fedurca/het68_3d_case/reference/img/prototyp.jpg

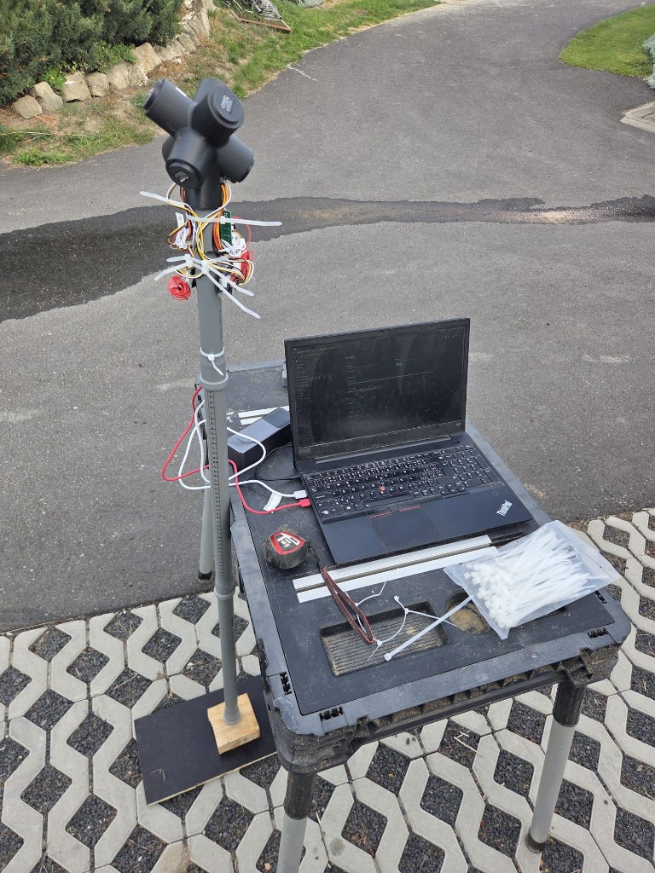
reference/img/prototyp.jpg
