fedurca/het68_3d_case/reference/img/spojka-iso.jpg

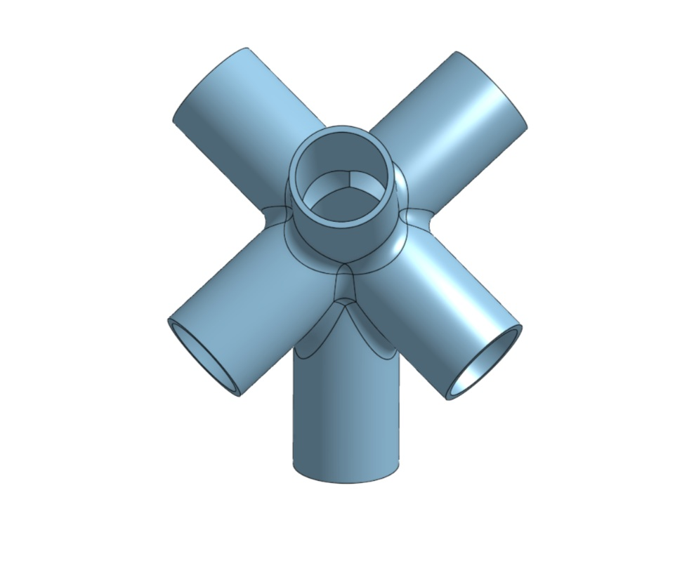
reference/img/spojka-iso.jpg
