fedurca/het68_3d_case/reference/img/spojka-rez.jpg

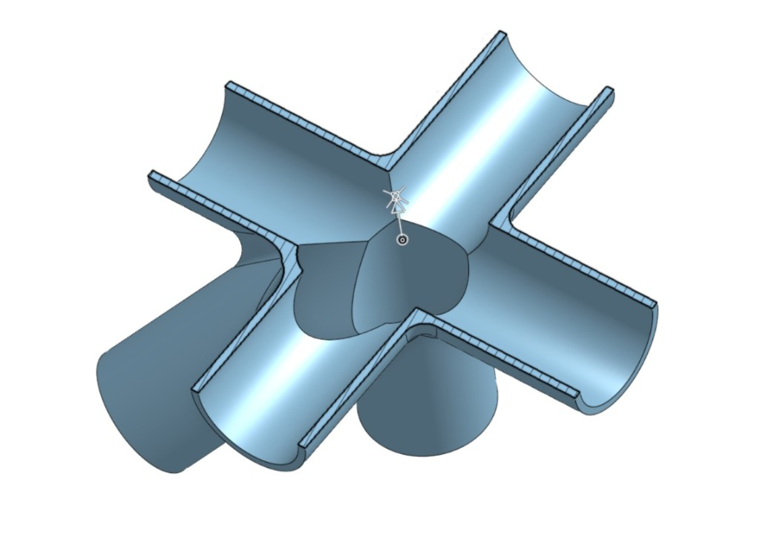
reference/img/spojka-rez.jpg
