fedurca/het68_3d_case/reference/img/spojka-vykres.jpg

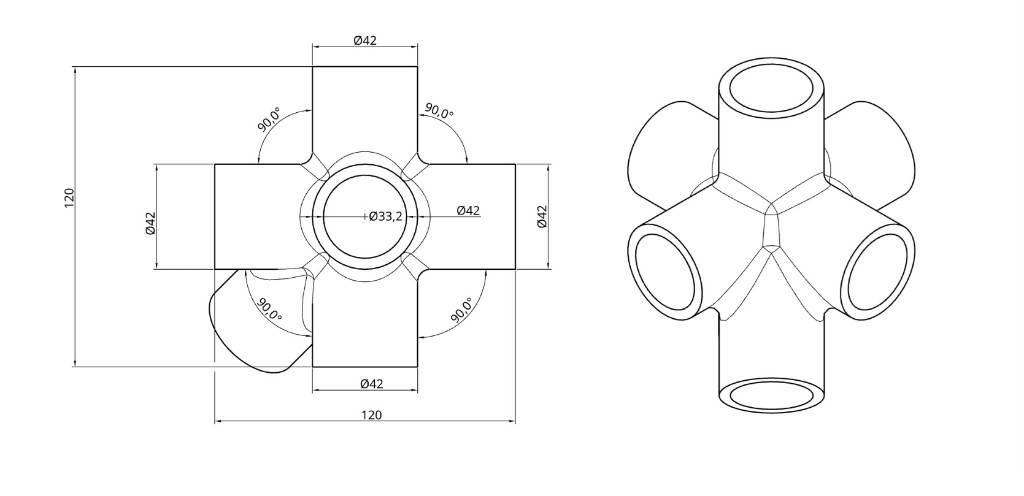
reference/img/spojka-vykres.jpg
