fedurca/het68_3d_case/reference/img/vicko-iso.jpg

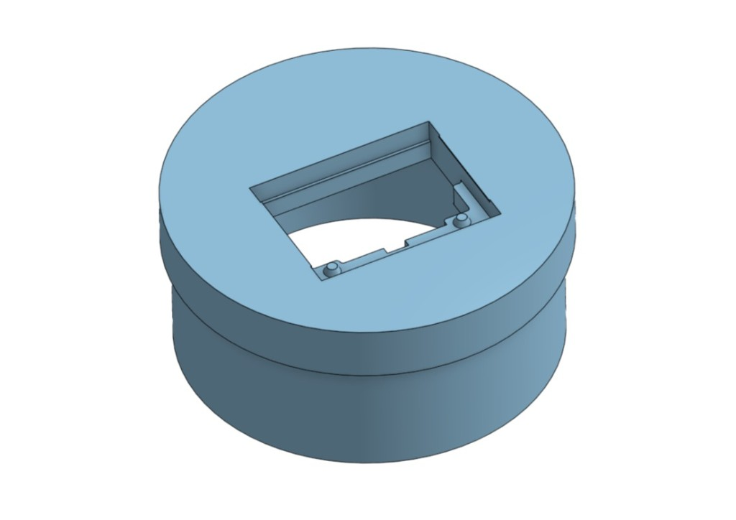
reference/img/vicko-iso.jpg
