fedurca/het68_3d_case/reference/img/vicko-pohled.jpg

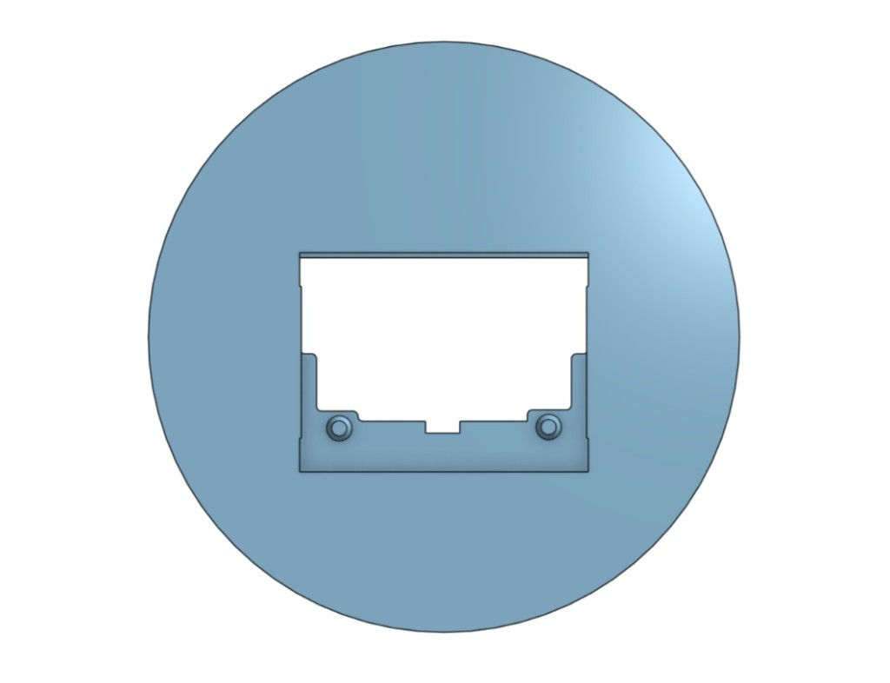
reference/img/vicko-pohled.jpg
