fedurca/het68_3d_case/export/step/pod.step

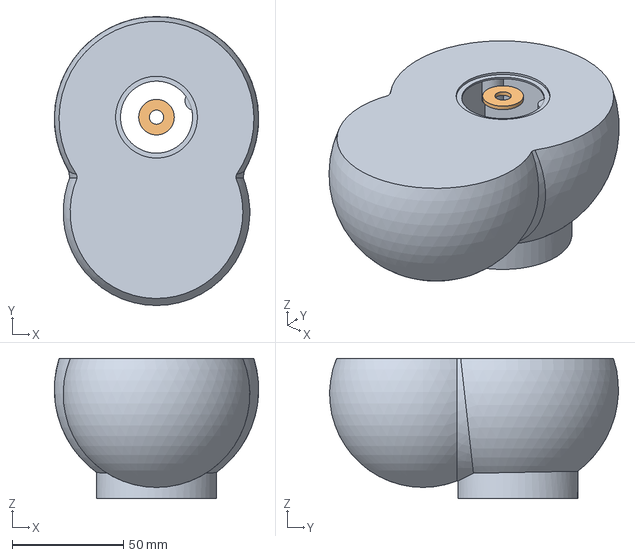
[picture p16: CAD file, 2026-10-29]
export/step/pod.step
91.9 x 130.0 x 63.0 mm
