fedurca/het68_3d_case/reference/stl/vicko.stl

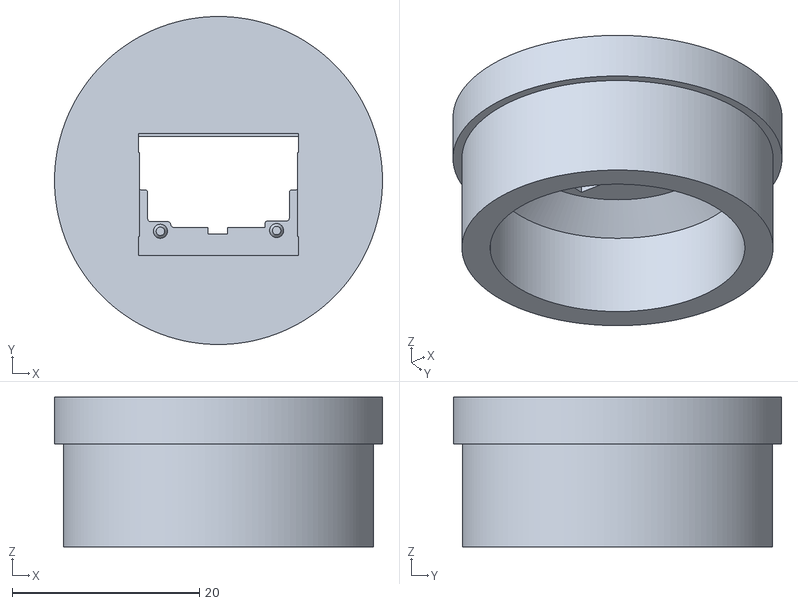
[picture p17: CAD file, 2026-10-29]
reference/stl/vicko.stl
35.0 x 35.0 x 16.0
