fedurca/het68_3d_case/export/step/hub_lower.step

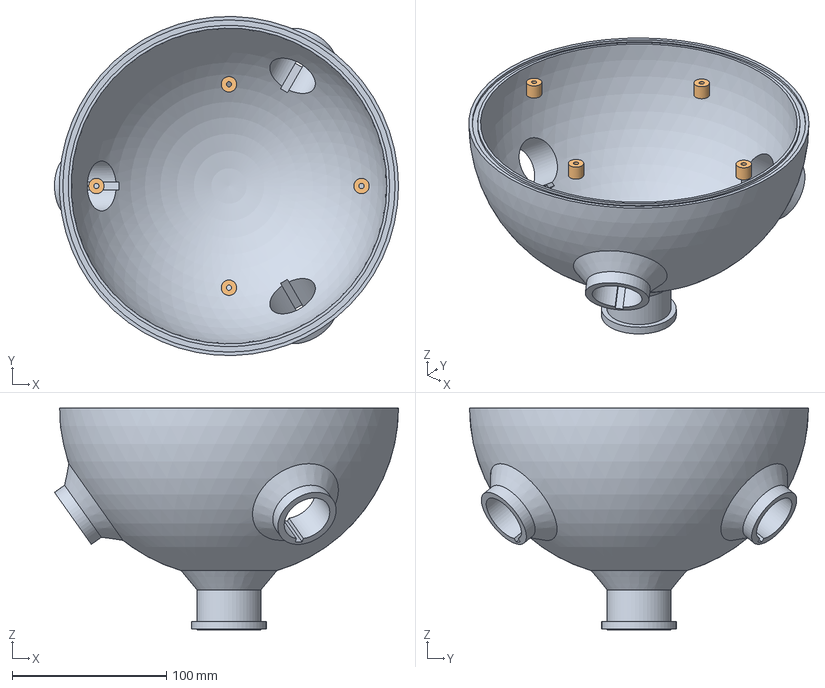
[picture p18: CAD file, 2026-10-29]
export/step/hub_lower.step
223.2 x 219.9 x 144.0 mm
