fedurca/het68_3d_case/reference/stl/spojka.stl

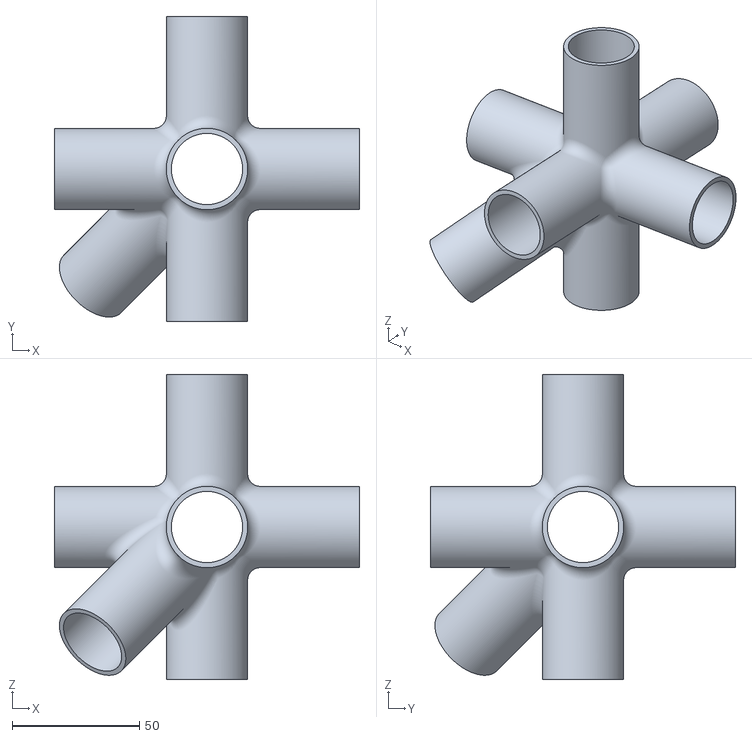
[picture p19: CAD file, 2026-10-29]
reference/stl/spojka.stl
120.0 x 120.0 x 120.0
