fedurca/het68_3d_case/export/step/pod_window.step

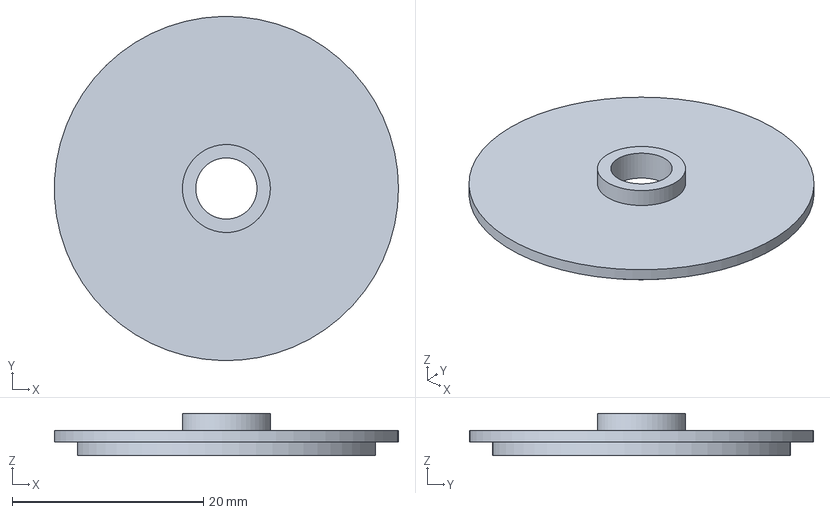
[picture p20: CAD file, 2026-10-29]
export/step/pod_window.step
36.0 x 36.0 x 4.40 mm
