fedurca/het68_3d_case/export/step/marks.step

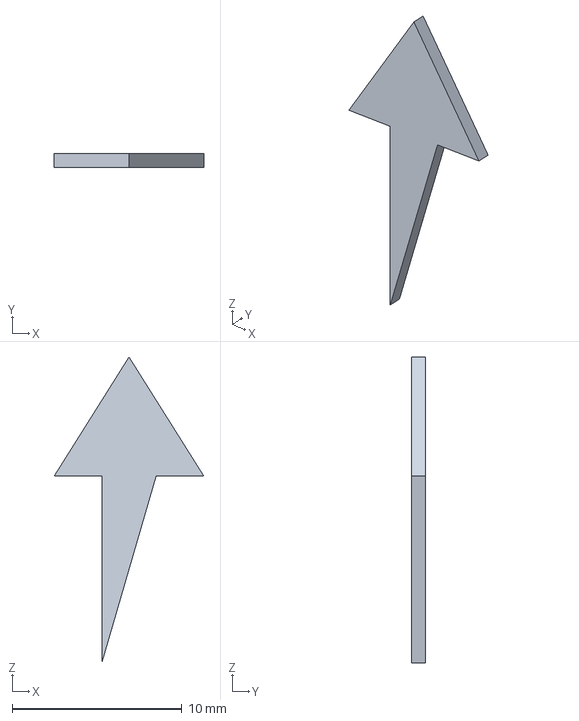
[picture p21: CAD file, 2026-10-29]
export/step/marks.step
8.80 x 0.8 x 18.0 mm
