fedurca/het68_3d_case/export/step/arm.step

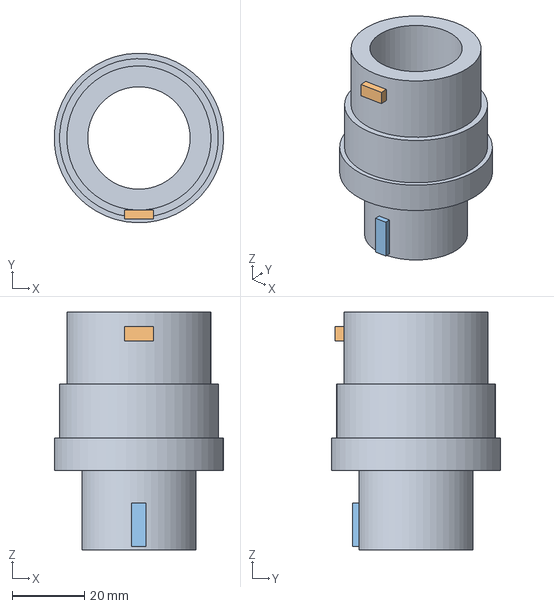
[picture p22: CAD file, 2026-10-29]
export/step/arm.step
47.0 x 47.0 x 66.0 mm
