fedurca/het68_3d_case/export/step/hub_upper.step

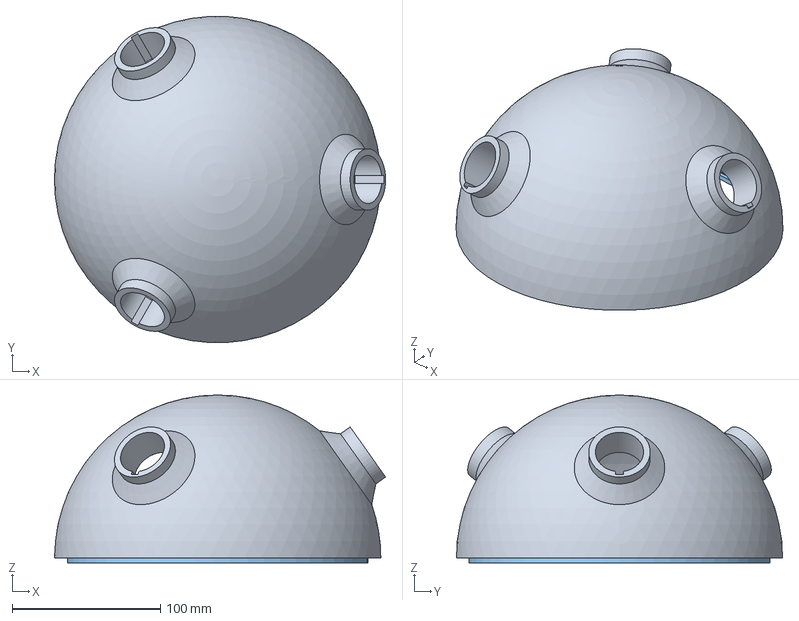
[picture p23: CAD file, 2026-10-29]
export/step/hub_upper.step
223.2 x 219.7 x 113.2 mm
