fedurca/het68_3d_case/(list of files, cad)

Other CAD files:
export/stl/arm.stl
export/stl/hub_lower.stl
export/stl/hub_upper.stl
export/stl/marks.stl
export/stl/pod.stl
export/stl/pod_window.stl
