fedurca/het68_3d_case/(commit log)

2026-10-29 Add the measured case references for the 384 mm array.
    The HT cross, lid, prototype photo and geometry notes are the baseline the new parts are built from.
    [spojka.stl, vicko.stl]
2026-10-29 Add the printable 384 mm cube-on-vertex case.
    HT DN 32 arms put the opposite T5848 planes 384 mm apart, and the boards sit in a box under the lower vertex.
    [arm.step, arm.stl, electronics_box.step, electronics_box.stl, electronics_lid.step, electronics_lid.stl, hub.step, hub.stl]
2026-10-29 Describe the printable parts in the README.
    Each part has its render and a link to the STL and STEP, so the 384 mm case can be read from the repository front page.
2026-10-29 Put the boards in the center of the seven-port hub.
    Satellite cables then share one length, and the six microphone arms stay identical so they disturb the sound the same way.
    [arm.step, arm.stl, electronics_box.step, electronics_box.stl, electronics_lid.step, electronics_lid.stl, hub.step, hub.stl]
2026-10-29 Seal the crown as a sphere so every microphone sees the same body.
    The six florets are one part, the joints are covered against rain, and the mast socket stays blind.
    [arm.step, arm.stl, hub_lower.step, hub_lower.stl, hub_upper.step, hub_upper.stl, marks.step, marks.stl]
